ldu04/bulsa/docs/img/dashboard_sim.png

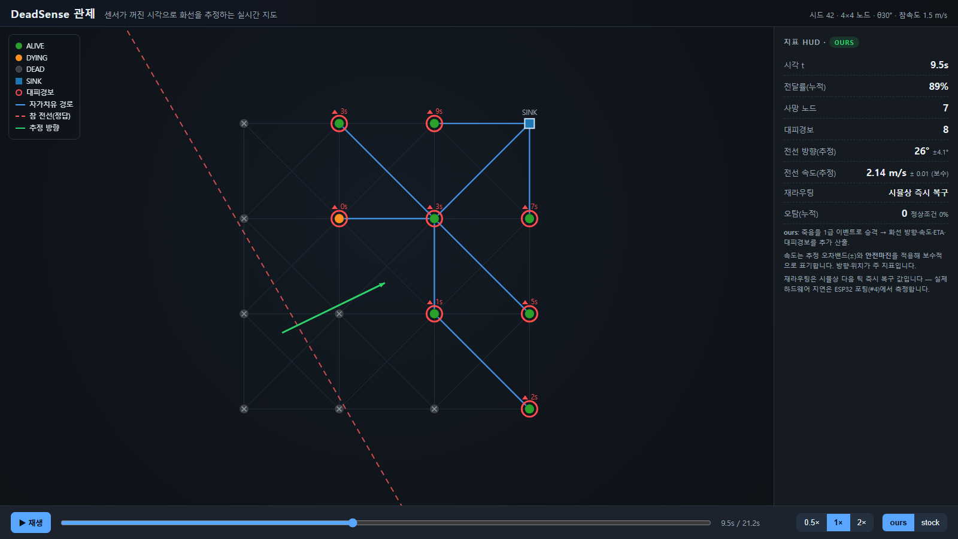
docs/img/dashboard_sim.png
