ldu04/bulsa/docs/img/gateway.jpg

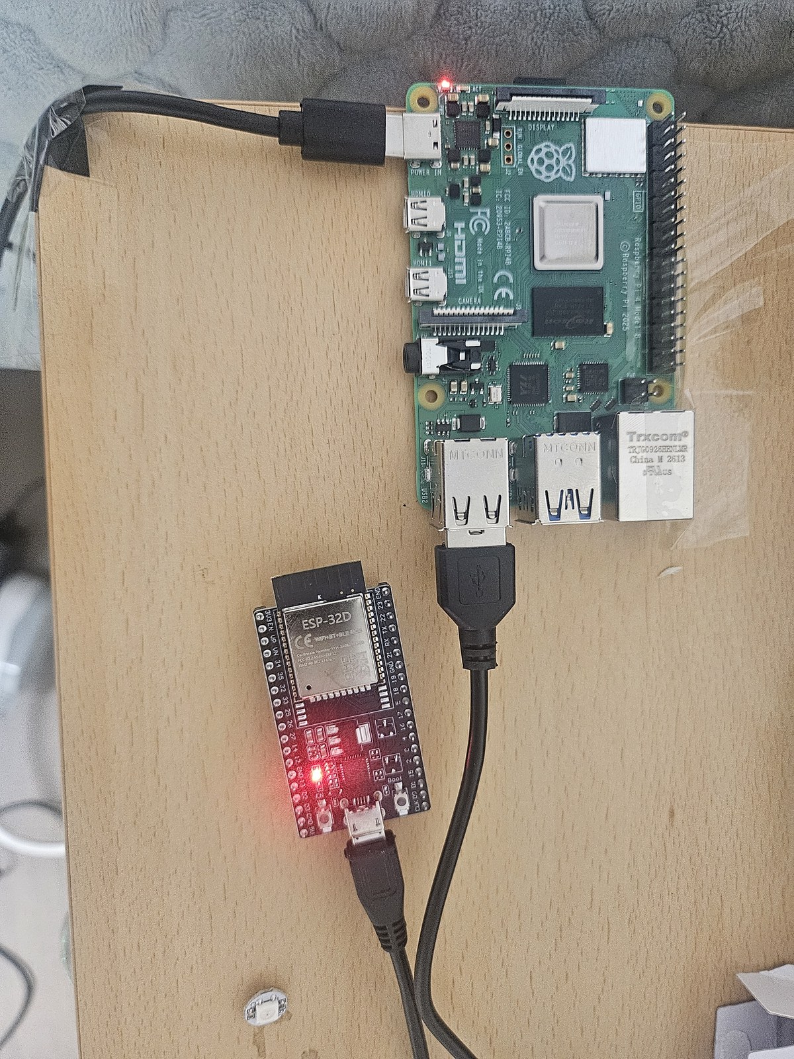
docs/img/gateway.jpg
