ldu04/bulsa/results/hw/pi16/README.txt

16노드 소크 — 촬영 당일 배치 · 파이에서 측정 (2026-08-31)

측정 조건
  브리지  : 라즈베리파이(bulsa) /dev/ttyUSB0
  급전    : 허브 11대(12V 5A) / 노트북 USB 1대(n09) / 충전기 2대(n02·n13) / 보조배터리 2대(n01·n05)
  길이    : 30.0분 (1801초), final=true

주요 결과 (상세 분석은 내일 문서화)
  합류        : 16 + 브리지 전원. 브리지 1.8초, 마지막 노드 n05 40.0초
  브리지 리셋 : 1회 (t=425.7s, Guru Meditation). abort 0 / task_wdt 0
  힙          : free 최저 56,220 B · max_alloc 최저 40,948 B (11대 회차와 동일)
  E BOD       : 0건 (브리지 로그 · 노드 COM7 자기시리얼 둘 다)
  >20s 이탈   : 467회 = 0.973 /노드/분   (11대 회차 0.297 의 3.3배)
  도착률      : 6.9 ~ 13.2% (중앙 9.7%)  ← 대수가 늘수록 악화
  브리지 HB   : 이탈 0회 · 간격 중앙 1.519s · 최대 2.894s
  4대 생존    : n01 n02 n05 생존 / ★ n13 미복귀 (마지막 HB t=1773 / 1801)

주의
  · summary.json 의 "_주의" 문구는 스크립트에 박힌 11구 허브용 문장이다.
    이 회차는 16대이므로 그 문장을 그대로 인용하지 말 것.
  · n13 미복귀가 전원 차단인지 유실 꼬리인지는 이 데이터로 못 가른다 (E BOD 0건).
