ldu04/bulsa/results/stress/curve_2e1_group_passrate.png

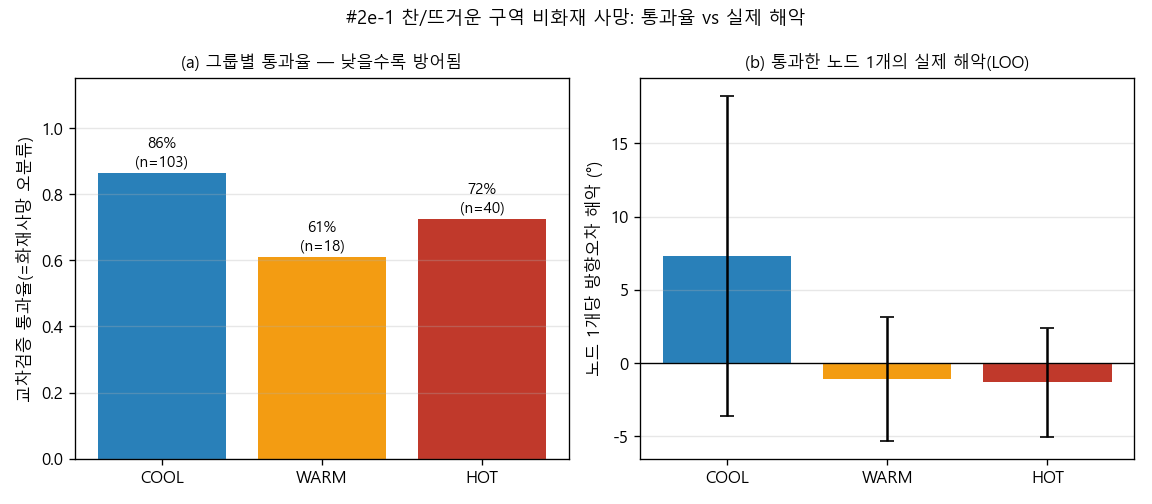
results/stress/curve_2e1_group_passrate.png
