ldu04/bulsa/results/stress/curve_2e1_harm_scale.png

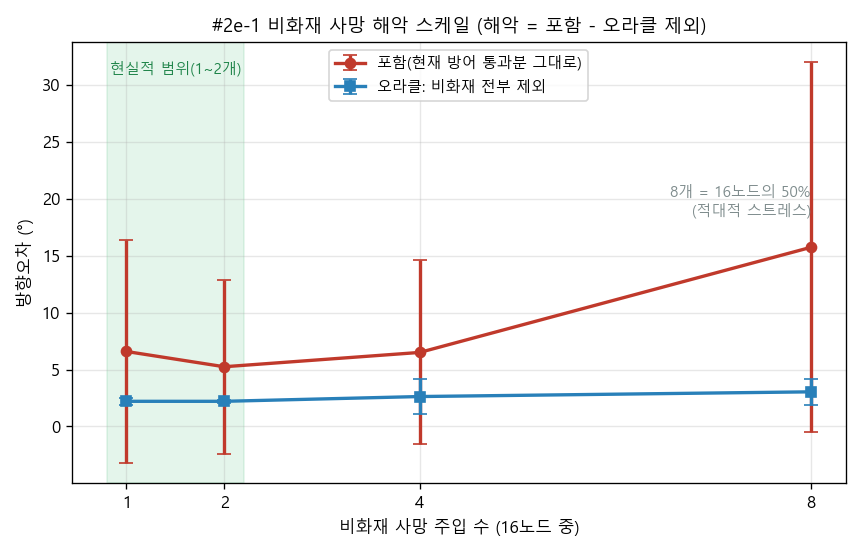
results/stress/curve_2e1_harm_scale.png
