ldu04/bulsa/results/stress/curve_2e2_variants.png

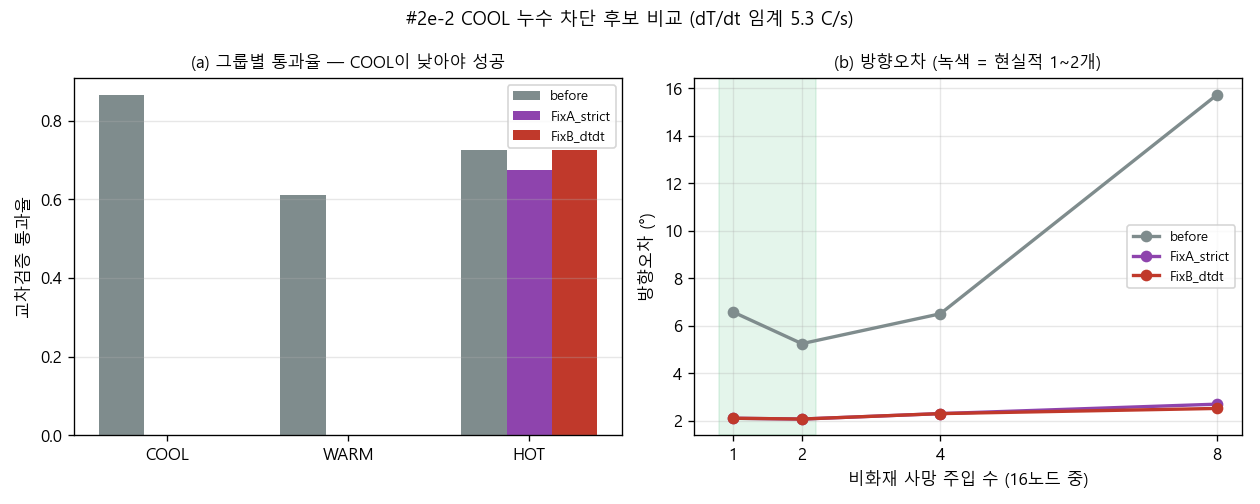
results/stress/curve_2e2_variants.png
