ldu04/bulsa/results/stress/curve_2j_a_tmax120.png

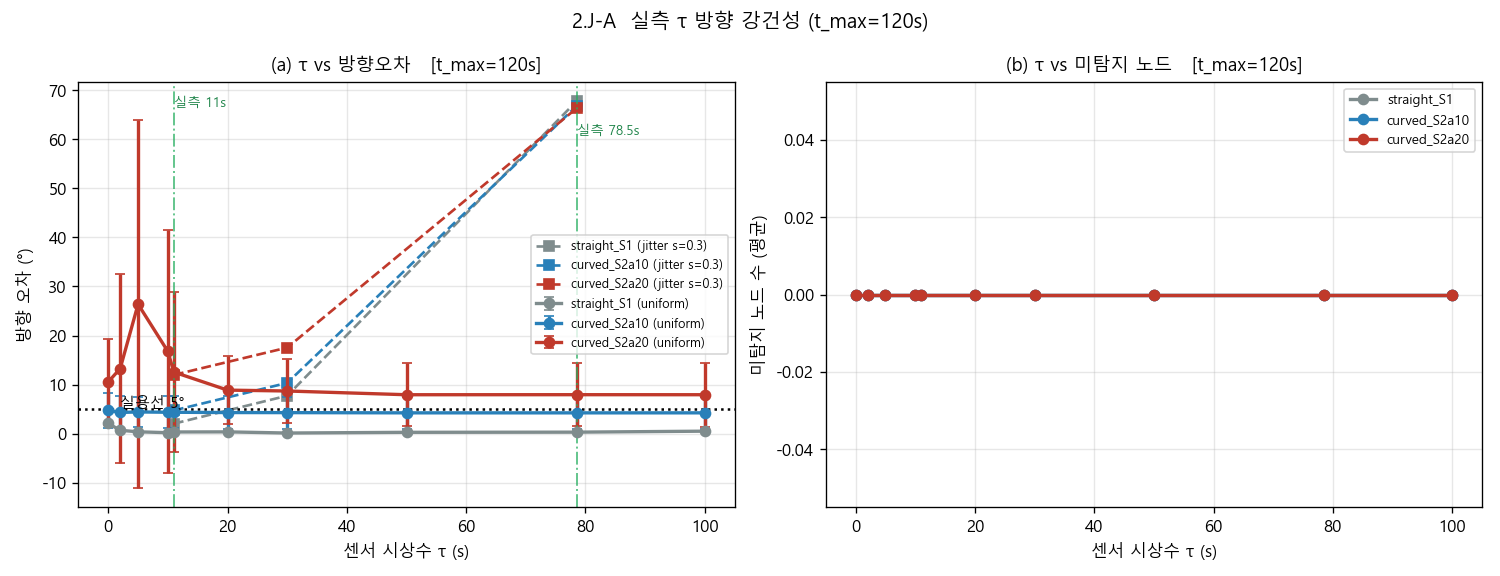
results/stress/curve_2j_a_tmax120.png
