ldu04/bulsa/results/stress/curve_2k_c_tradeoff.png

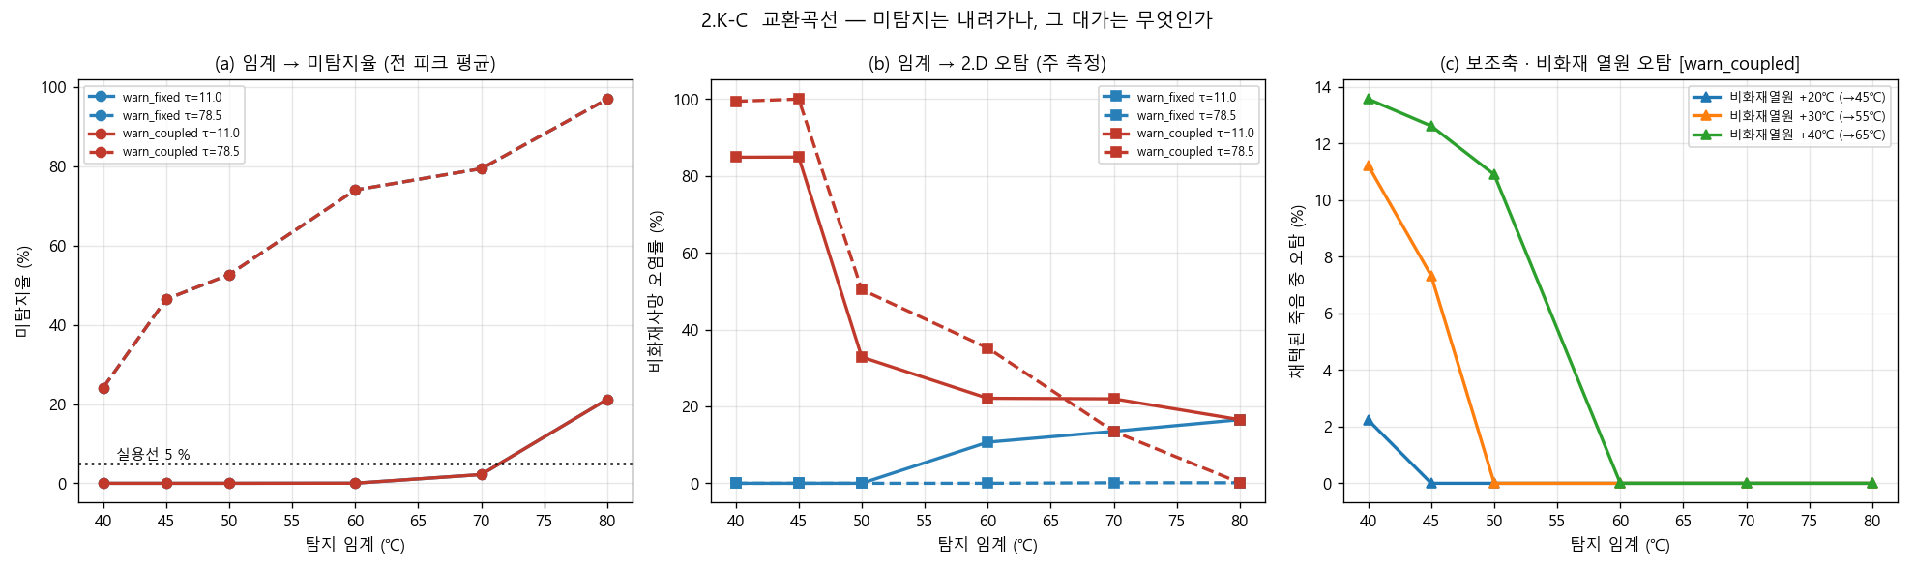
results/stress/curve_2k_c_tradeoff.png
