ldu04/bulsa/results/stress/curve_2k_d_speed_eta_tmax120.png

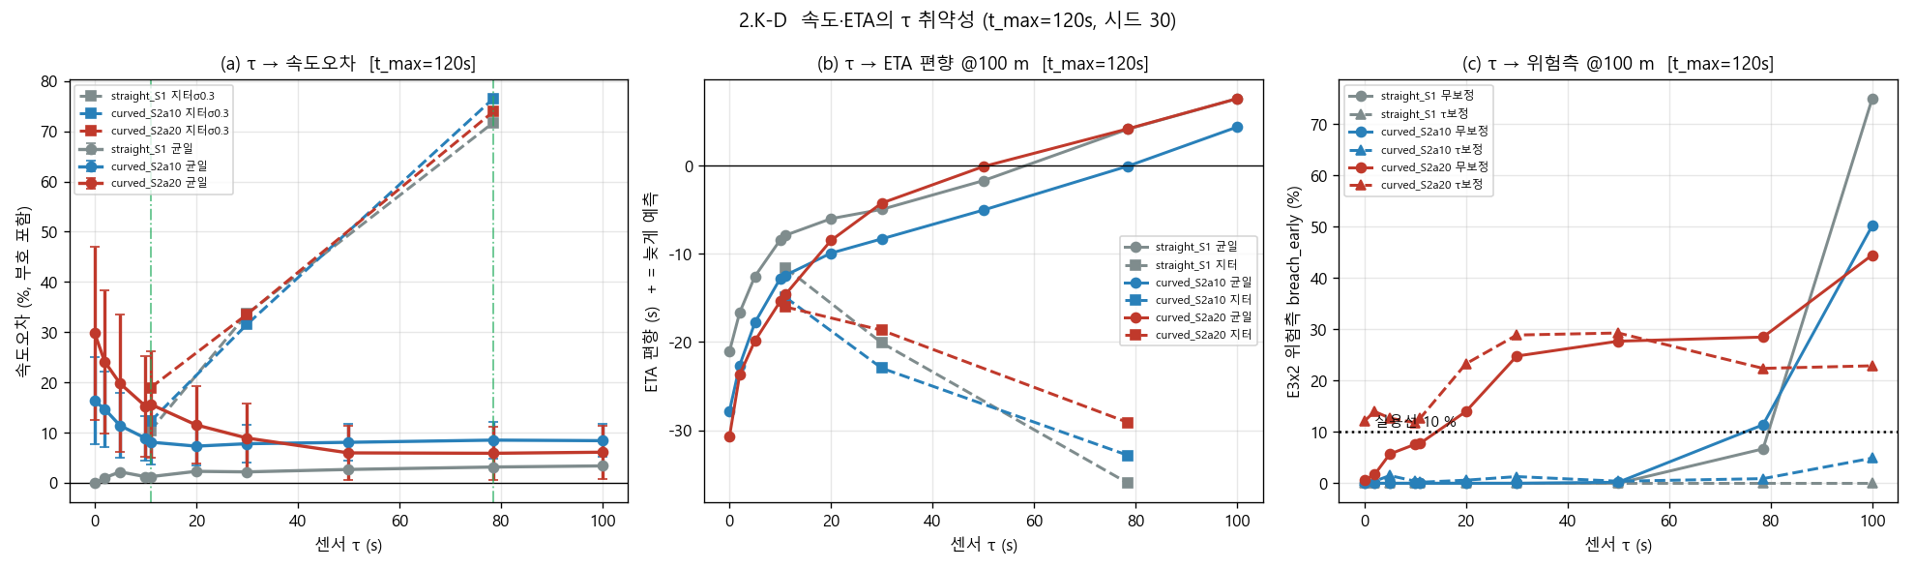
results/stress/curve_2k_d_speed_eta_tmax120.png
