ldu04/bulsa/results/stress/curve_2k_e_wind_coupled.png

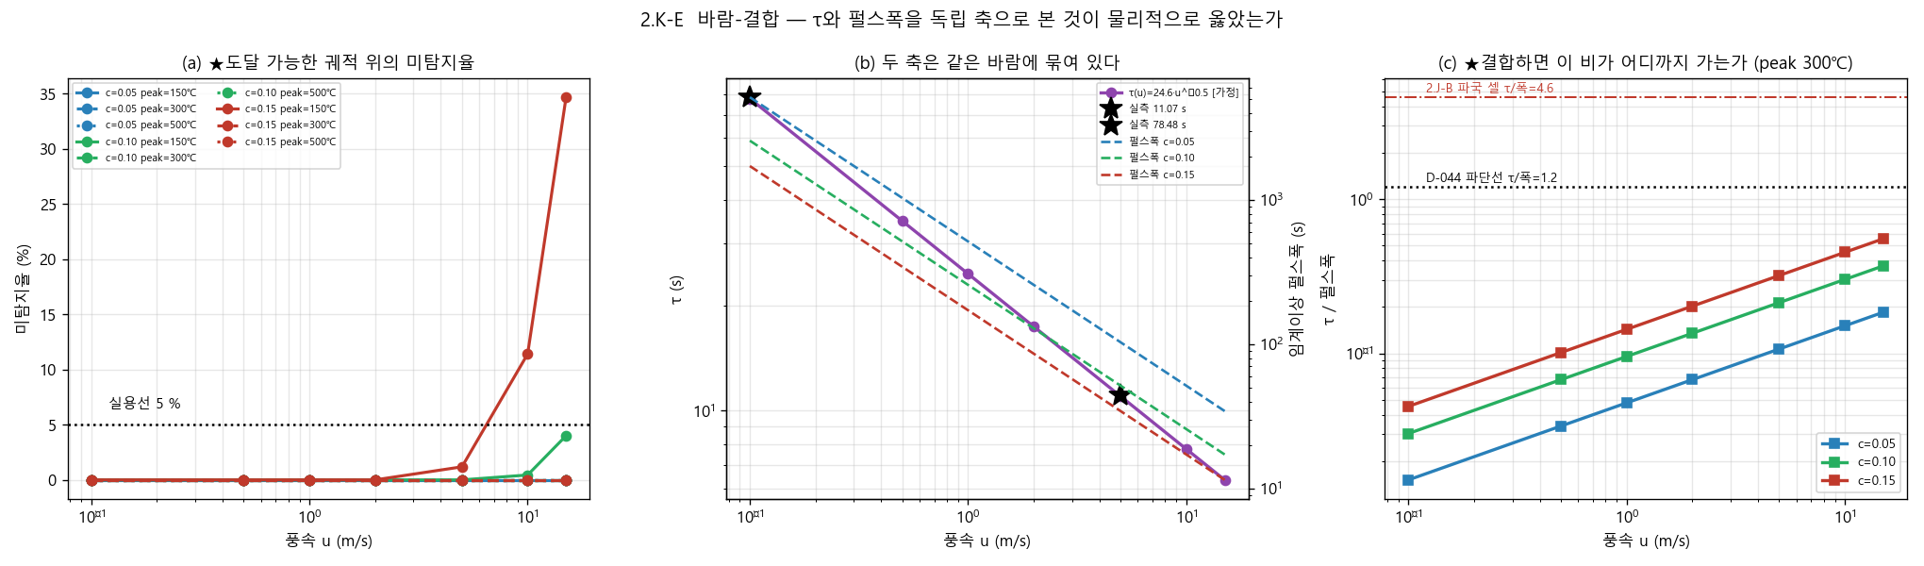
results/stress/curve_2k_e_wind_coupled.png
