ldu04/bulsa/results/stress/curve_2l_a_absolute.png

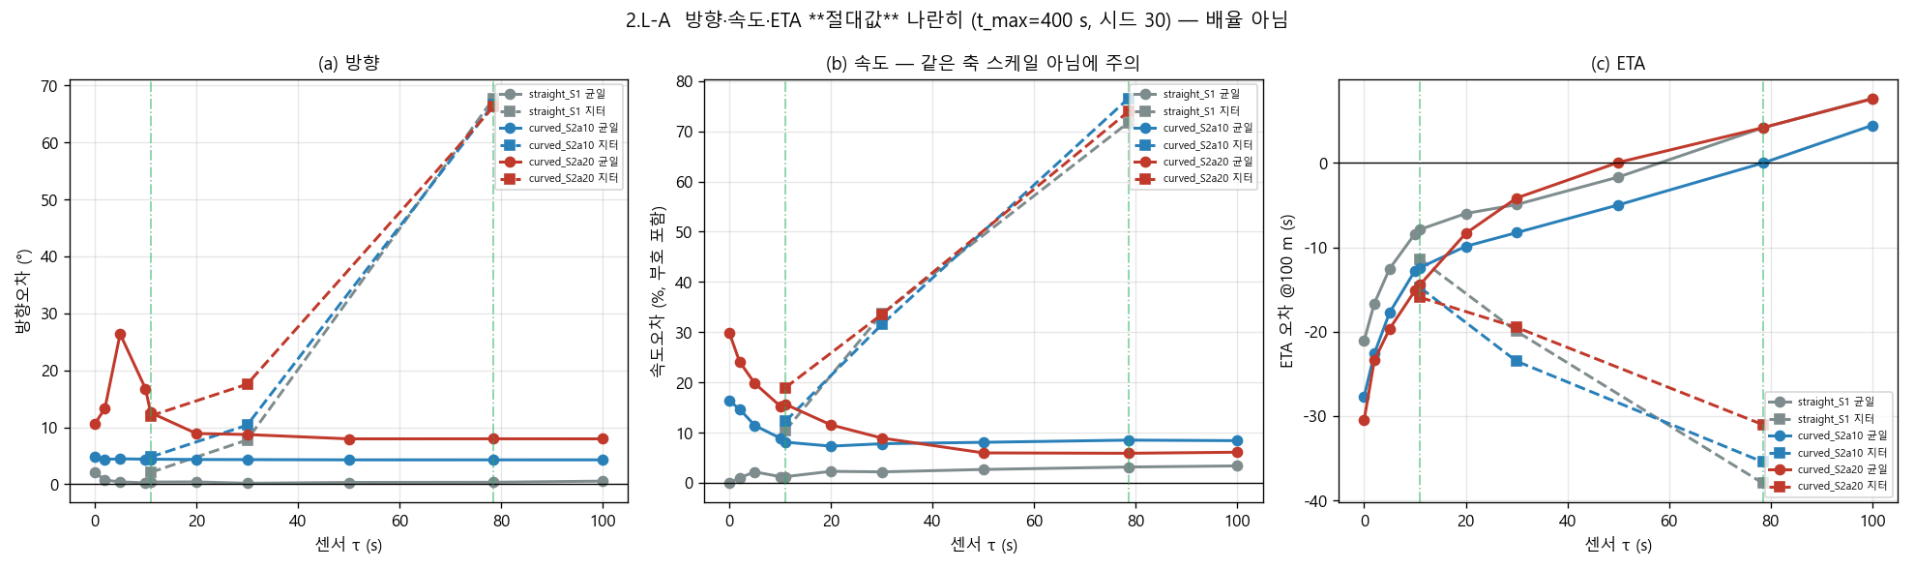
results/stress/curve_2l_a_absolute.png
