ldu04/bulsa/results/stress/curve_2l_b_ellipse.png

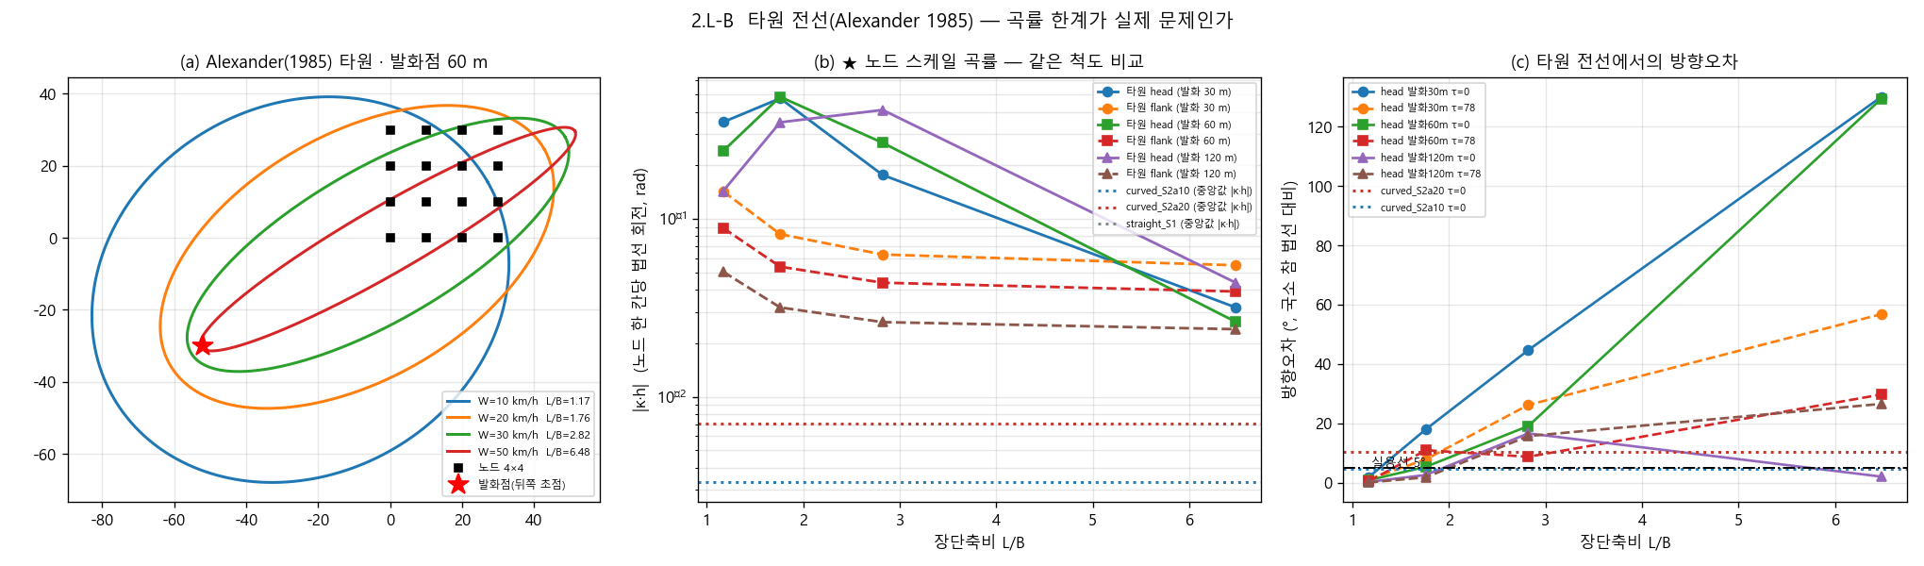
results/stress/curve_2l_b_ellipse.png
