ldu04/bulsa/results/stress/curve_2m_c_curvature_vs_starvation.png

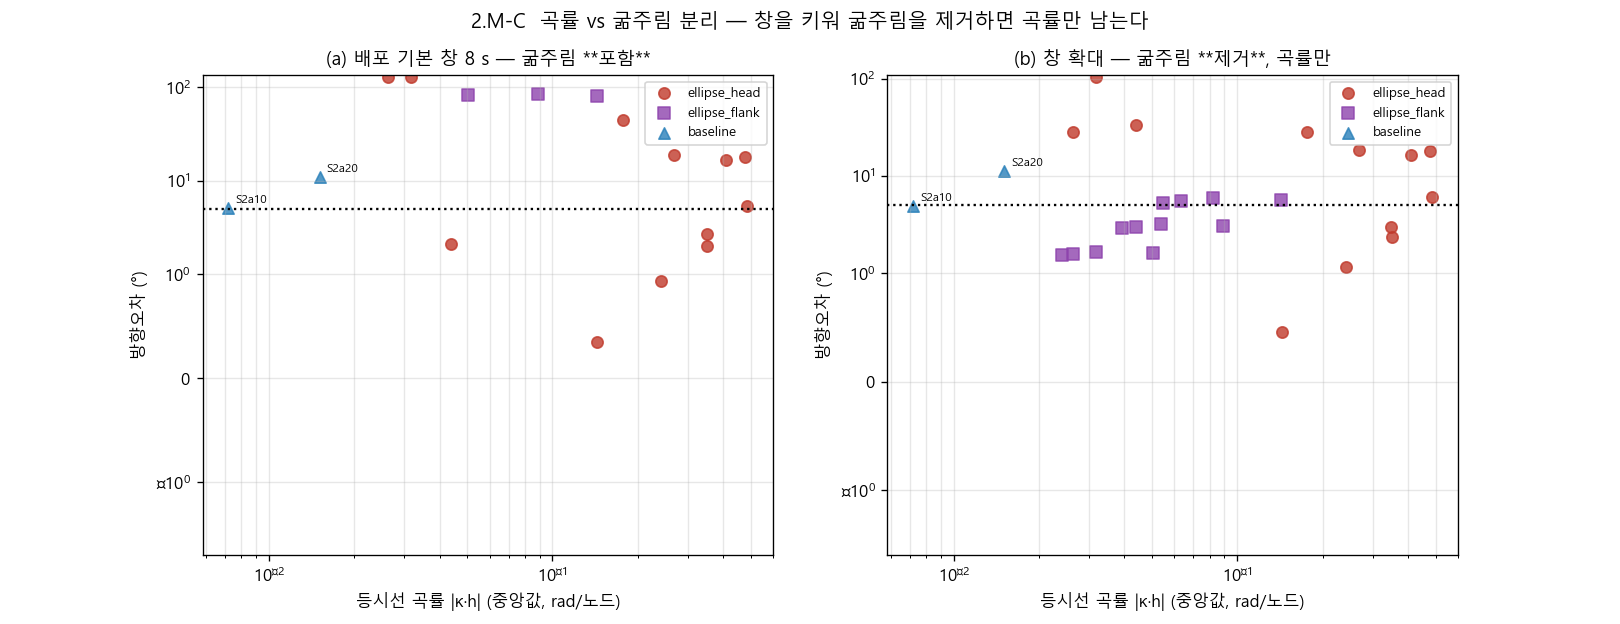
results/stress/curve_2m_c_curvature_vs_starvation.png
