ldu04/bulsa/results/stress/curve_S2_wind_dir.png

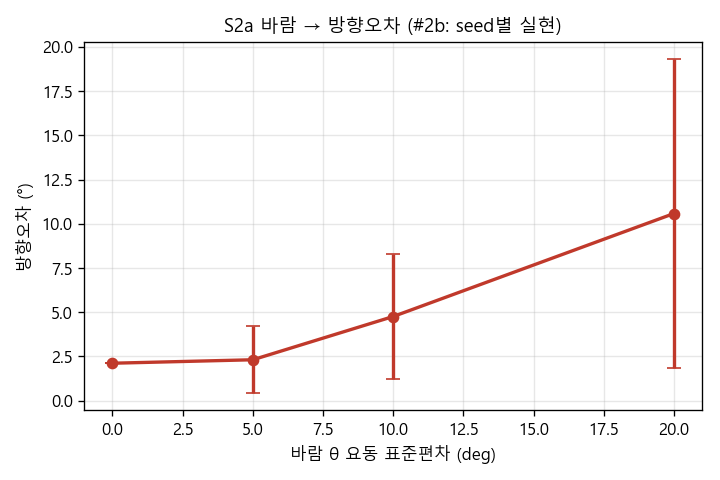
results/stress/curve_S2_wind_dir.png
