ldu04/bulsa/results/stress/curve_S2b_gust_speed.png

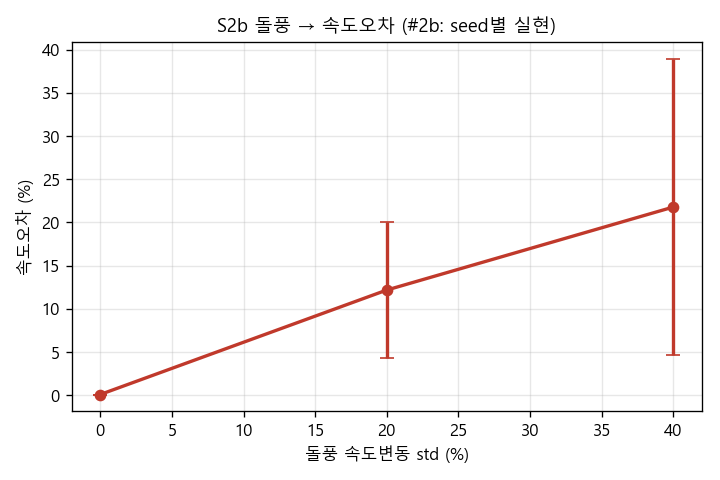
results/stress/curve_S2b_gust_speed.png
