ldu04/bulsa/results/stress/curve_S4_jitter_dir.png

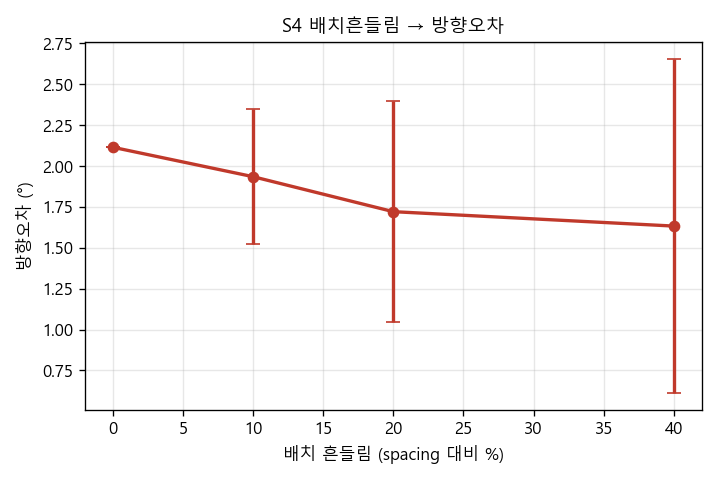
results/stress/curve_S4_jitter_dir.png
