ldu04/bulsa/results/stress/curve_S5_dropout_delivery.png

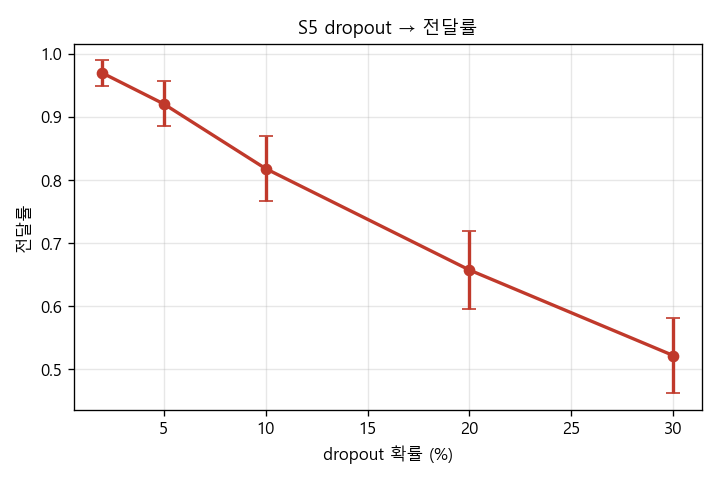
results/stress/curve_S5_dropout_delivery.png
