ldu04/bulsa/results/stress/curve_S5_dropout_fp.png

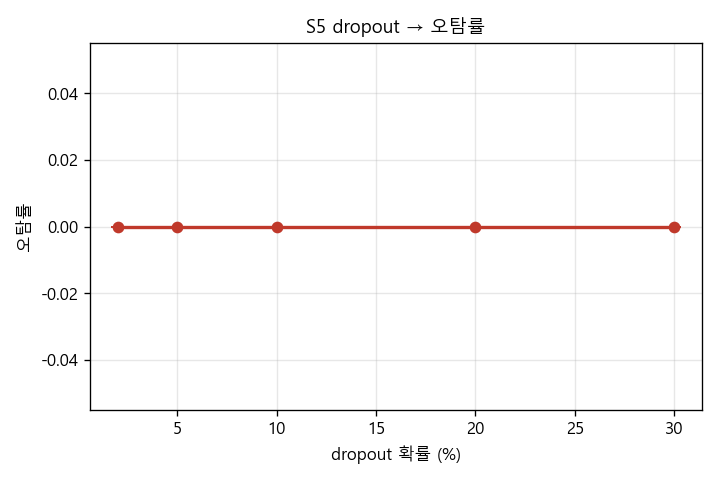
results/stress/curve_S5_dropout_fp.png
