ldu04/bulsa/results/stress/curve_S6_density_dir.png

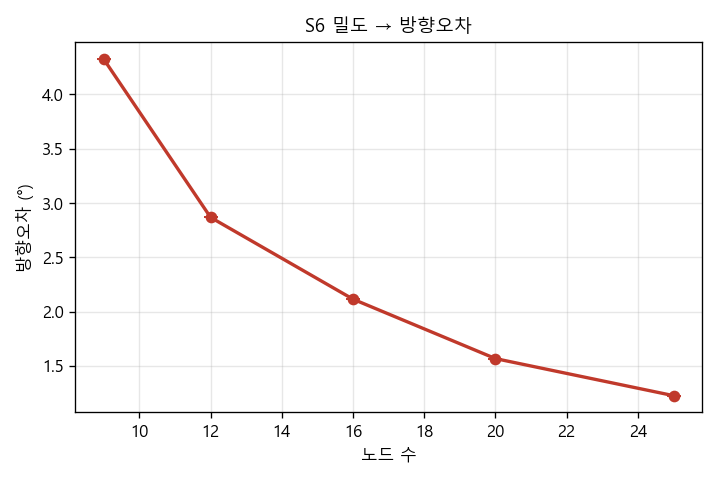
results/stress/curve_S6_density_dir.png
