ldu04/bulsa/results/stress/curve_S6_density_speed.png

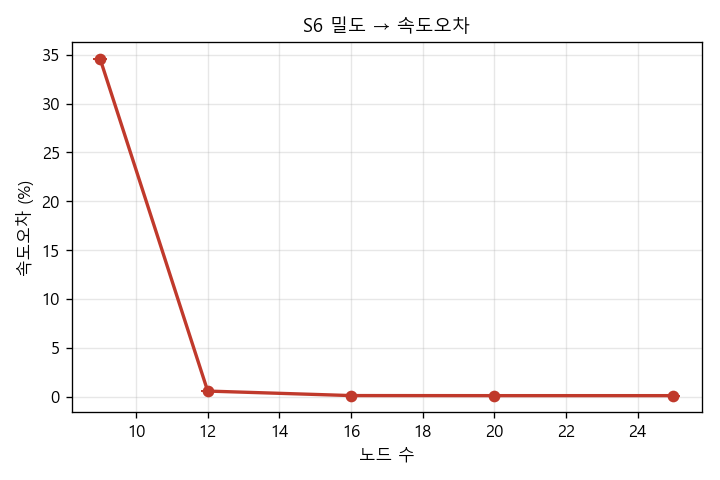
results/stress/curve_S6_density_speed.png
