ldu04/bulsa/results/stress/curve_S8_clock_dir.png

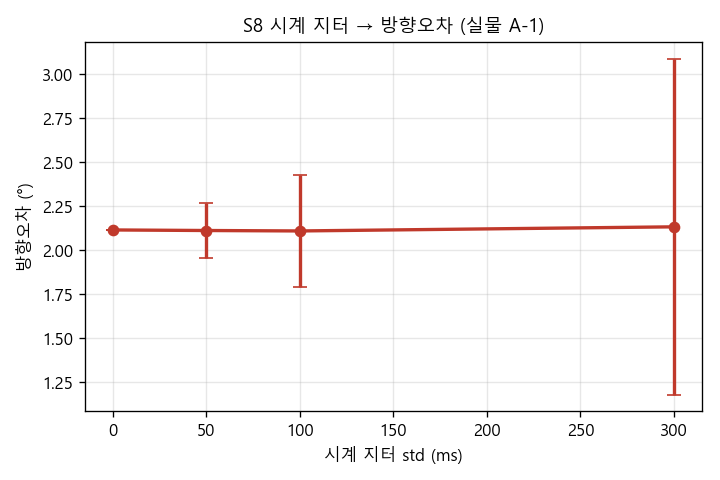
results/stress/curve_S8_clock_dir.png
