ldu04/bulsa/results/stress/curve_S8_clock_speed.png

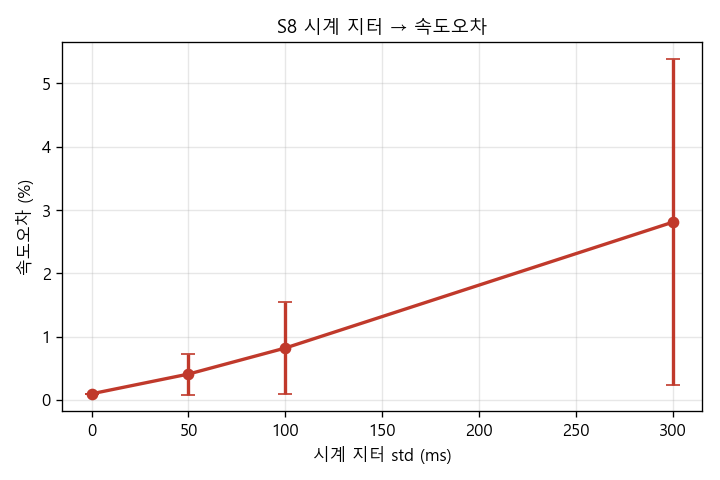
results/stress/curve_S8_clock_speed.png
