ldu04/bulsa/results/stress/curve_S9_temp_dir.png

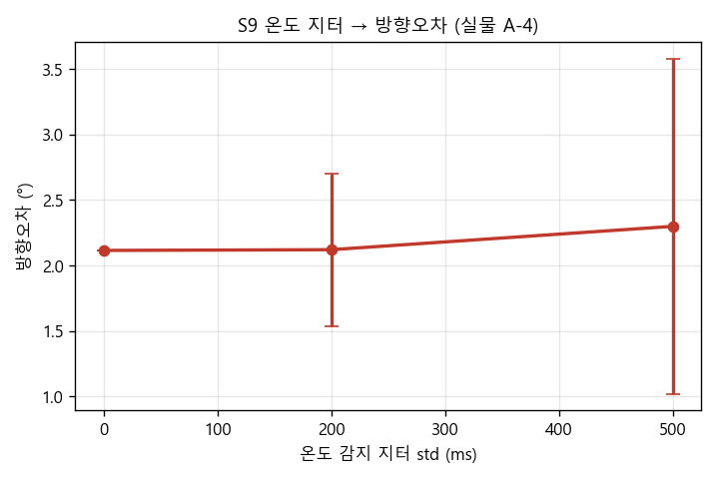
results/stress/curve_S9_temp_dir.png
