ldu04/bulsa/results/stress/curve_S10_spot_cov.png

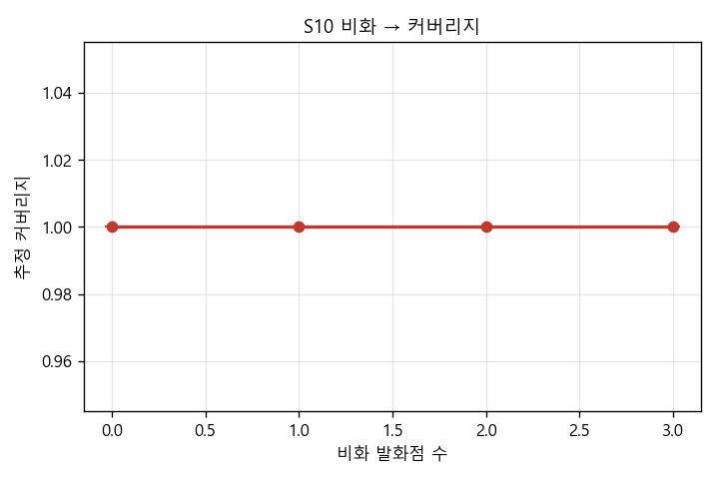
results/stress/curve_S10_spot_cov.png
