ldu04/bulsa/results/stress/curve_S10_spot_dir.png

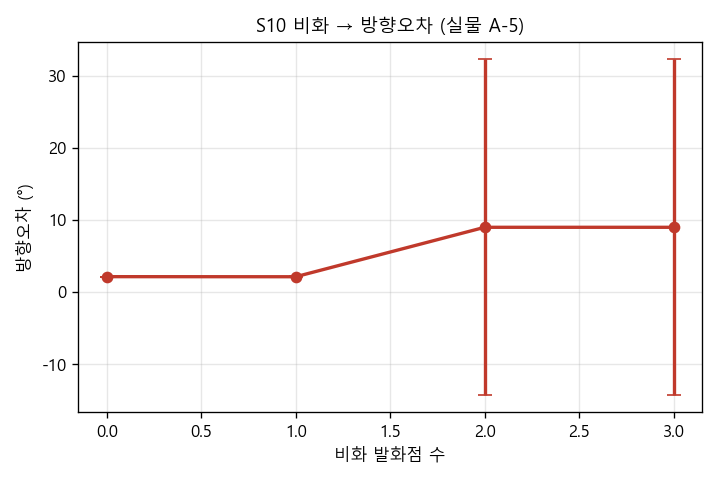
results/stress/curve_S10_spot_dir.png
