ldu04/bulsa/results/stress/curve_S11_nonfire_dir_beforeafter.png

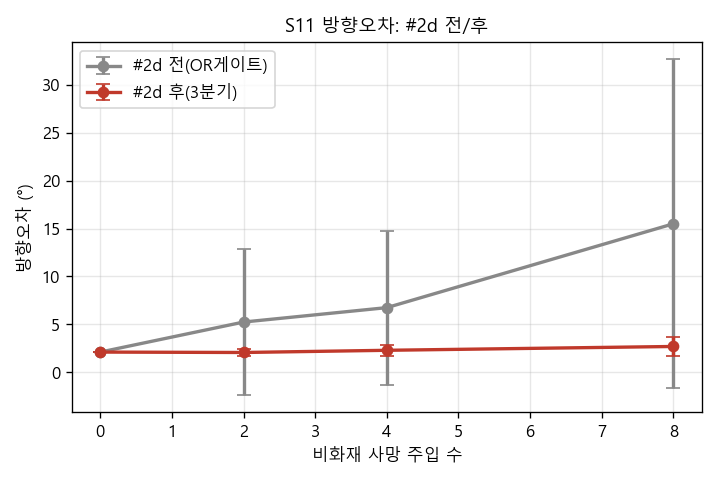
results/stress/curve_S11_nonfire_dir_beforeafter.png
