ldu04/bulsa/results/stress/curve_S11_nonfire_pollution_beforeafter.png

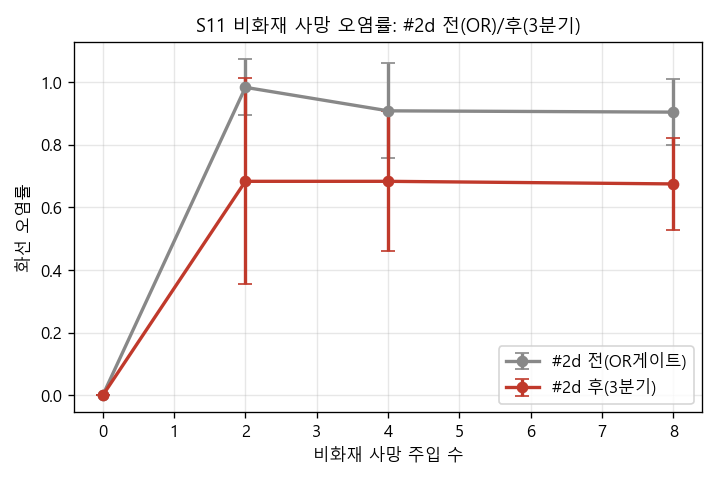
results/stress/curve_S11_nonfire_pollution_beforeafter.png
