ldu04/bulsa/results/stress/heat_2j_b_miss_vs_peak_tau.png

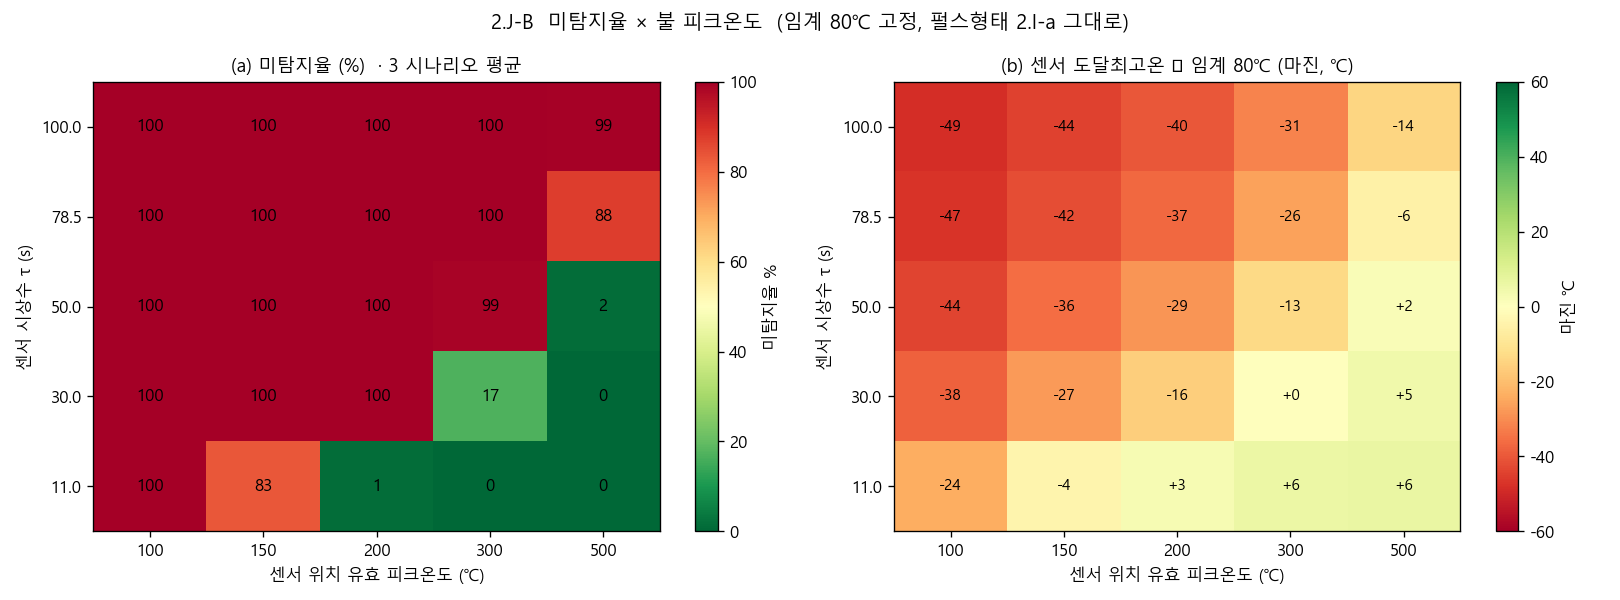
results/stress/heat_2j_b_miss_vs_peak_tau.png
