ldu04/bulsa/results/stress/heat_2k_c_miss_vs_threshold_warn_coupled.png

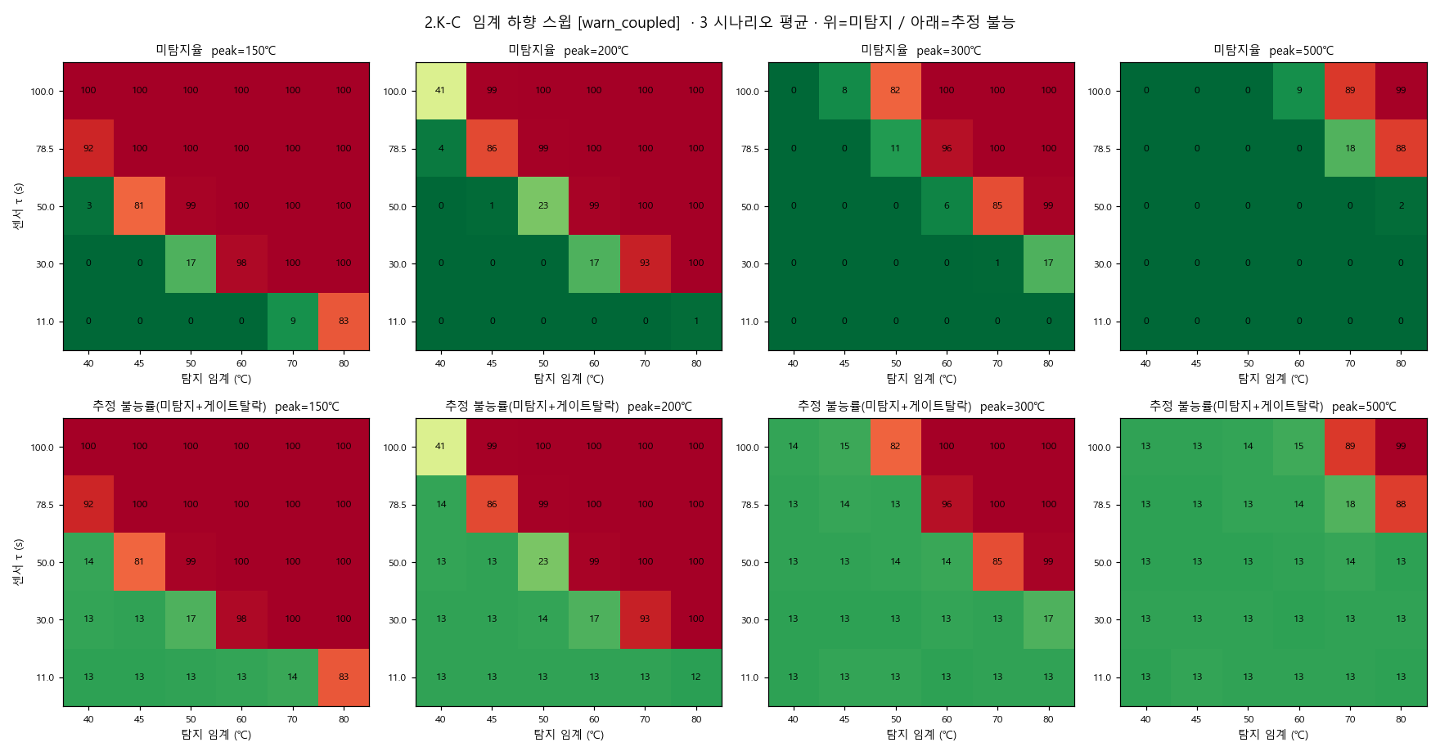
results/stress/heat_2k_c_miss_vs_threshold_warn_coupled.png
