ldu04/bulsa/(commit log)

2026-11-02 불사: 센서 소멸 시각 기반 산불 화선 추정 — 코드·실물 실험 기록·모의실험 결과
    [build_log.csv, burn_map.csv, comparison_stock_vs_ours.csv, d1_deaths.csv, density_sweep.csv, gateway_deaths.csv, nodes.csv, pi16_filming_events.csv]
2026-11-05 이름을 DeadSense 로: README·대시보드 제목·캡처 다시 찍음, 예전 저장소 이름 흔적 정리
2026-11-05 방향 오차 원인 재계산 스크립트 추가 (둥근 화선 vs 직선 화선 vs 시계 오차)
